AayushmanDas/LucidAC/media/3D_viewer.png

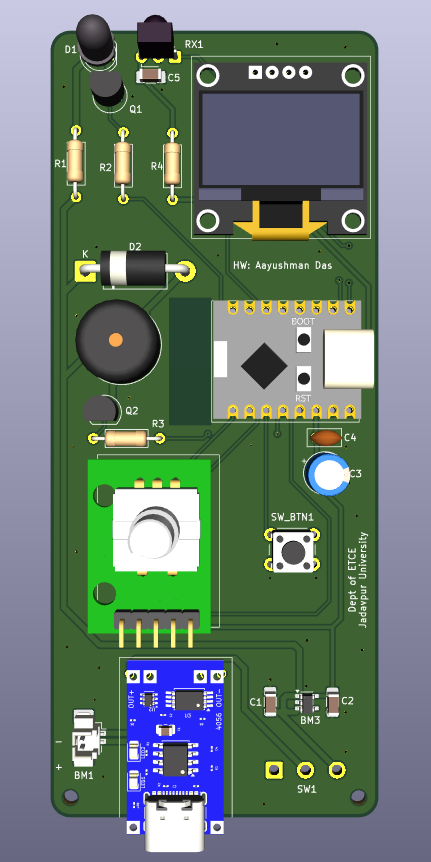
media/3D_viewer.png
