AayushmanDas/LucidAC/media/battery_location.jpg

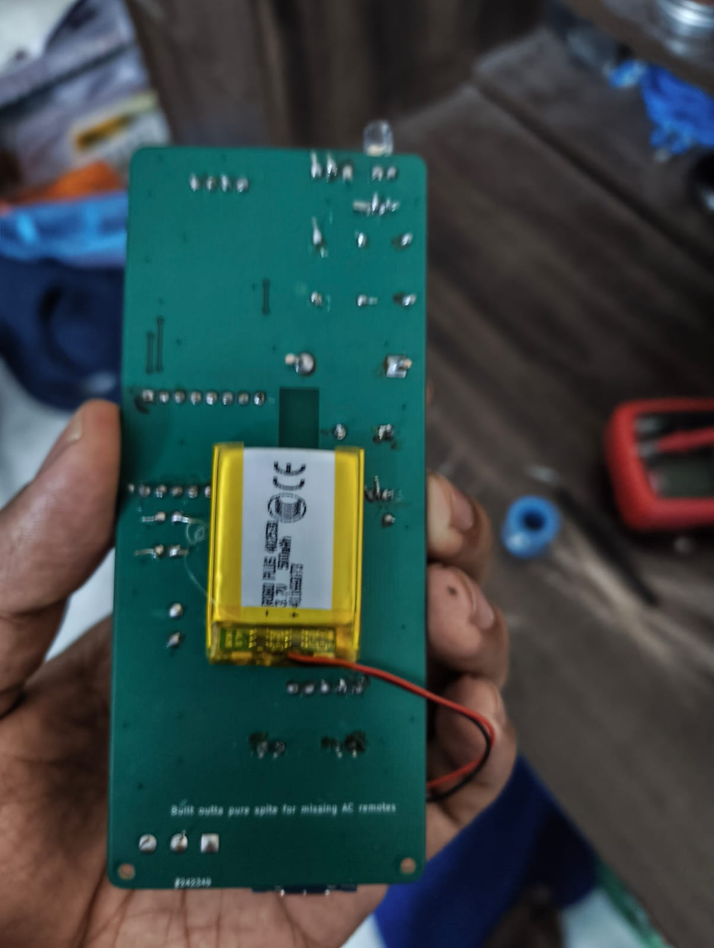
media/battery_location.jpg
