AayushmanDas/LucidAC/media/eschema_view.png

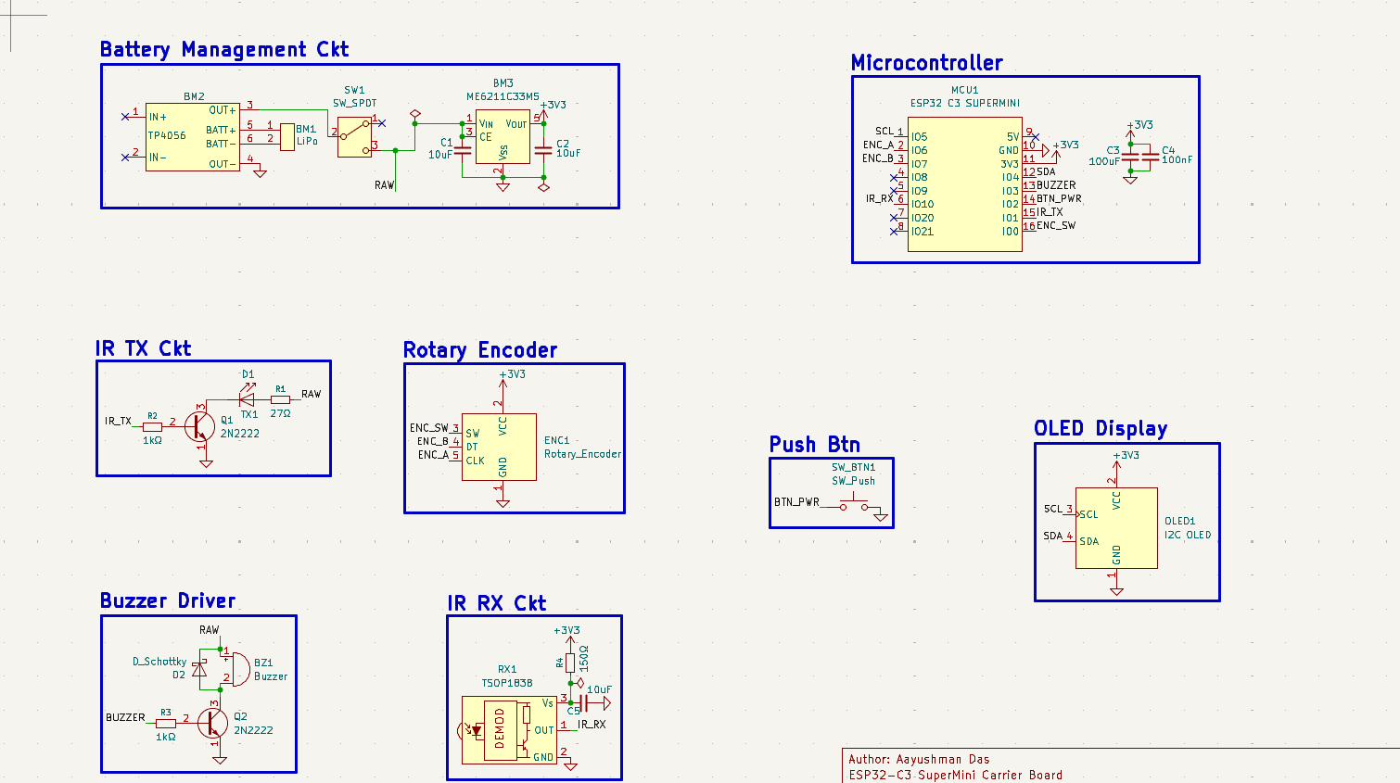
media/eschema_view.png
