AayushmanDas/LucidAC/media/pcbnew_view.png

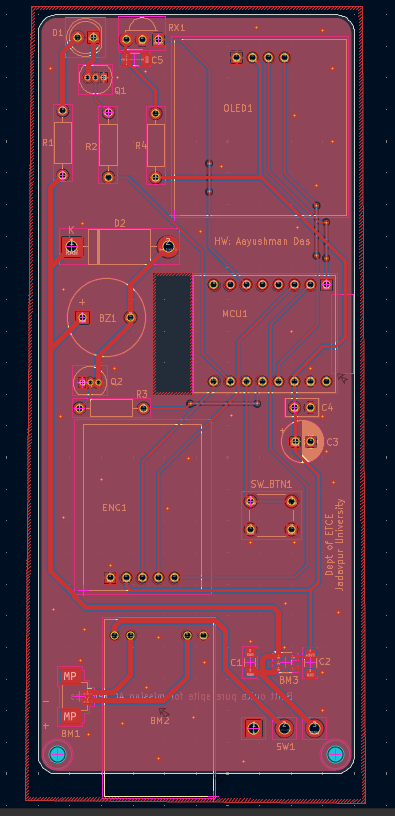
media/pcbnew_view.png
