AayushmanDas/LucidAC/media/ui_demo.jpg

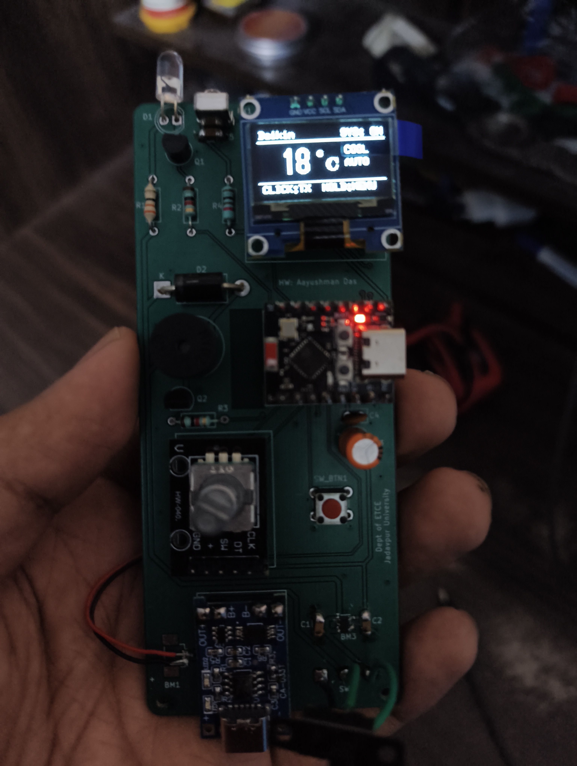
media/ui_demo.jpg
