AayushmanDas/LucidAC/hardware/JU_IR_Clean/Custom_3D_Models/HW-040 Encoder module.stp

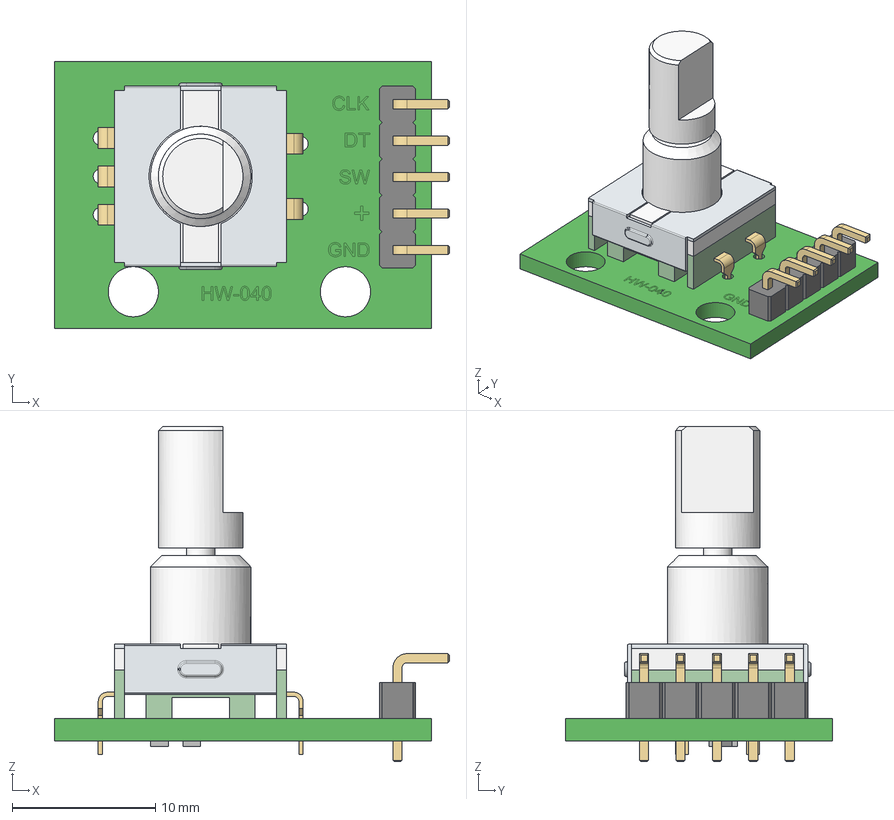
[picture p7: CAD file, 2026-10-14]
hardware/JU_IR_Clean/Custom_3D_Models/HW-040 Encoder module.stp
27.6 x 18.6 x 23.4 mm
Encoder PCB
Knob static part
Knob rotary part
Top plate knob
Plastic bottom knob
Encoder terminal x 5
1X5 Pin Socket
Bend pin x 5
0805 Terminal x 4
0805 Resistor Body x 2
