AayushmanDas/LucidAC/mechanical/JU_IR_Clean.step

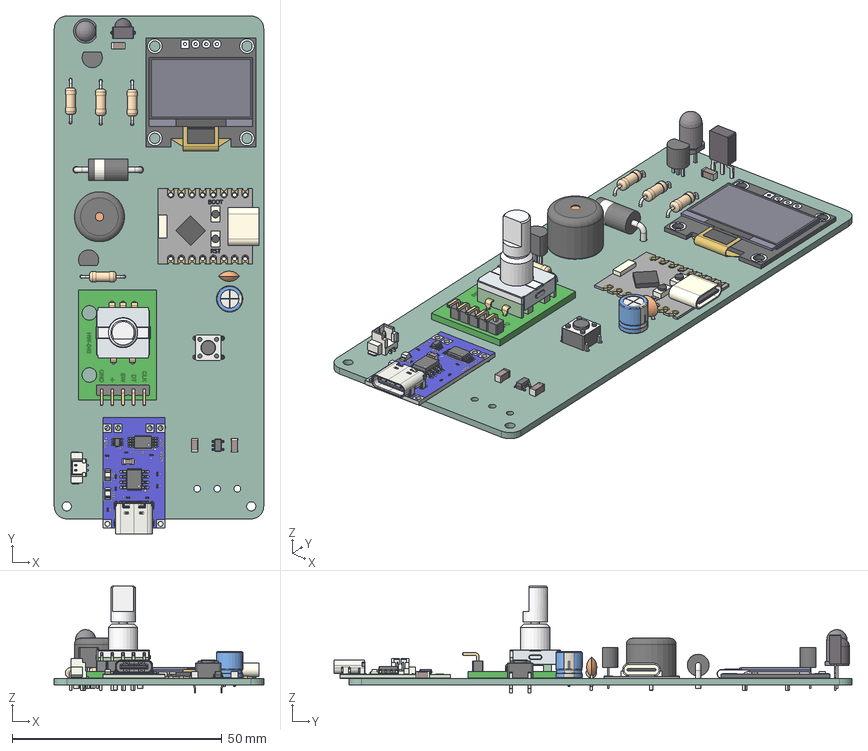
[picture p8: CAD file, 2026-10-14]
mechanical/JU_IR_Clean.step
50.0 x 123.6 x 25.4 mm
SW_PUSH_6mm
Molex_53398_0271
C_1206_3216Metric x 3
CP_Radial_D63mm_P250mm
R_Axial_DIN0207_L63mm_D25mm_P1016mm_Horizontal x 4
Vishay_MINICAST-3pin
Buzzer_12x95RM76
LED_D5.0mm_IRGrey
D_DO-201AD_P15.24mm_Horizontal
C_Disc_D50mm_W25mm_P250mm
TO-92_Inline_Narrow x 2
SOT-23-5
Body - PCB
Body - Back Panel
Body - Adhesive Pad
Body - Front Panel
Body - Flex Connector Bend
Body - Flex Connector Terminals
Body - Black Tape
Body - Protective Foil
Body - Screen Border
Extrude - Annular Rings
Encoder PCB
Knob static part
Knob rotary part
Top plate knob
Plastic bottom knob
Encoder terminal x 5
1X5 Pin Socket
Bend pin x 5
0805 Terminal x 4
0805 Resistor Body x 2
R_01005_0402Metric x 7
C_01005_0402Metric x 3
LED_0805_2012Metric x 2
SOT-363_SC-70-6
SOIC-8_3.9x4.9mm_P1.27mm
TSSOP-8_4.4x3mm_P0.65mm
USB_C_Receptacle_16P_TopMnt_Horizontal_GCT_USB4105-xx-A
C_0805_2012Metric
TP41F36_pad
TP41F36_silkscreen
TP41F36_soldermask x 2
TP41F36_PCB
JU_2A8B_PCB
