AayushmanDas/LucidAC/mechanical/IR_Enclosure.stl

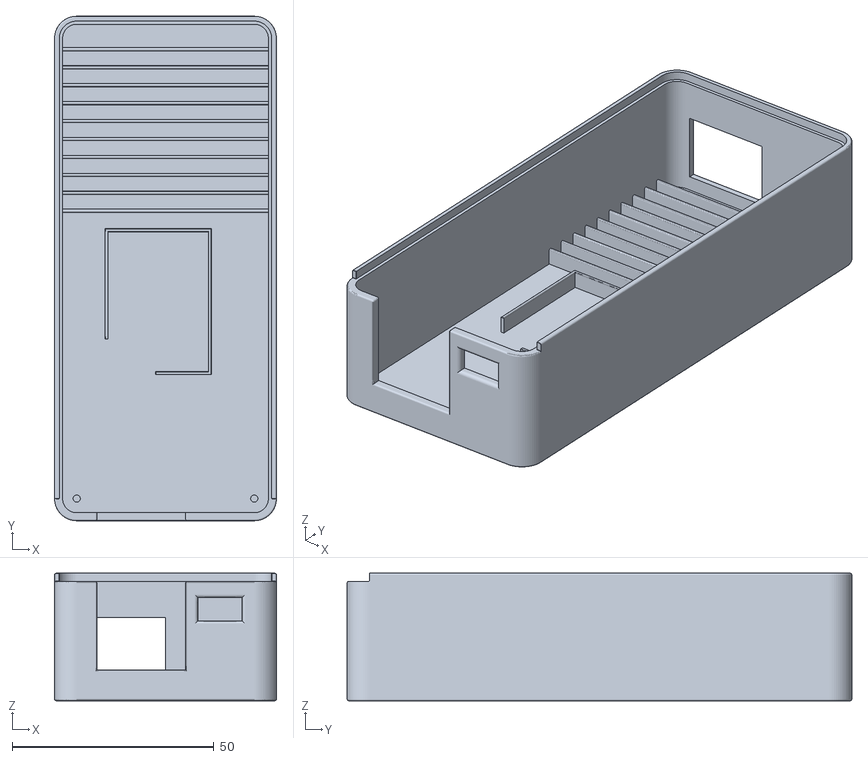
[picture p9: CAD file, 2026-10-14]
mechanical/IR_Enclosure.stl
55.0 x 125.0 x 31.6
