AayushmanDas/LucidAC/hardware/JU_IR_Clean/JU_IR_Clean.kicad_pcb

## KiCad design hardware/JU_IR_Clean/JU_IR_Clean.kicad_pcb (2026-10-14)

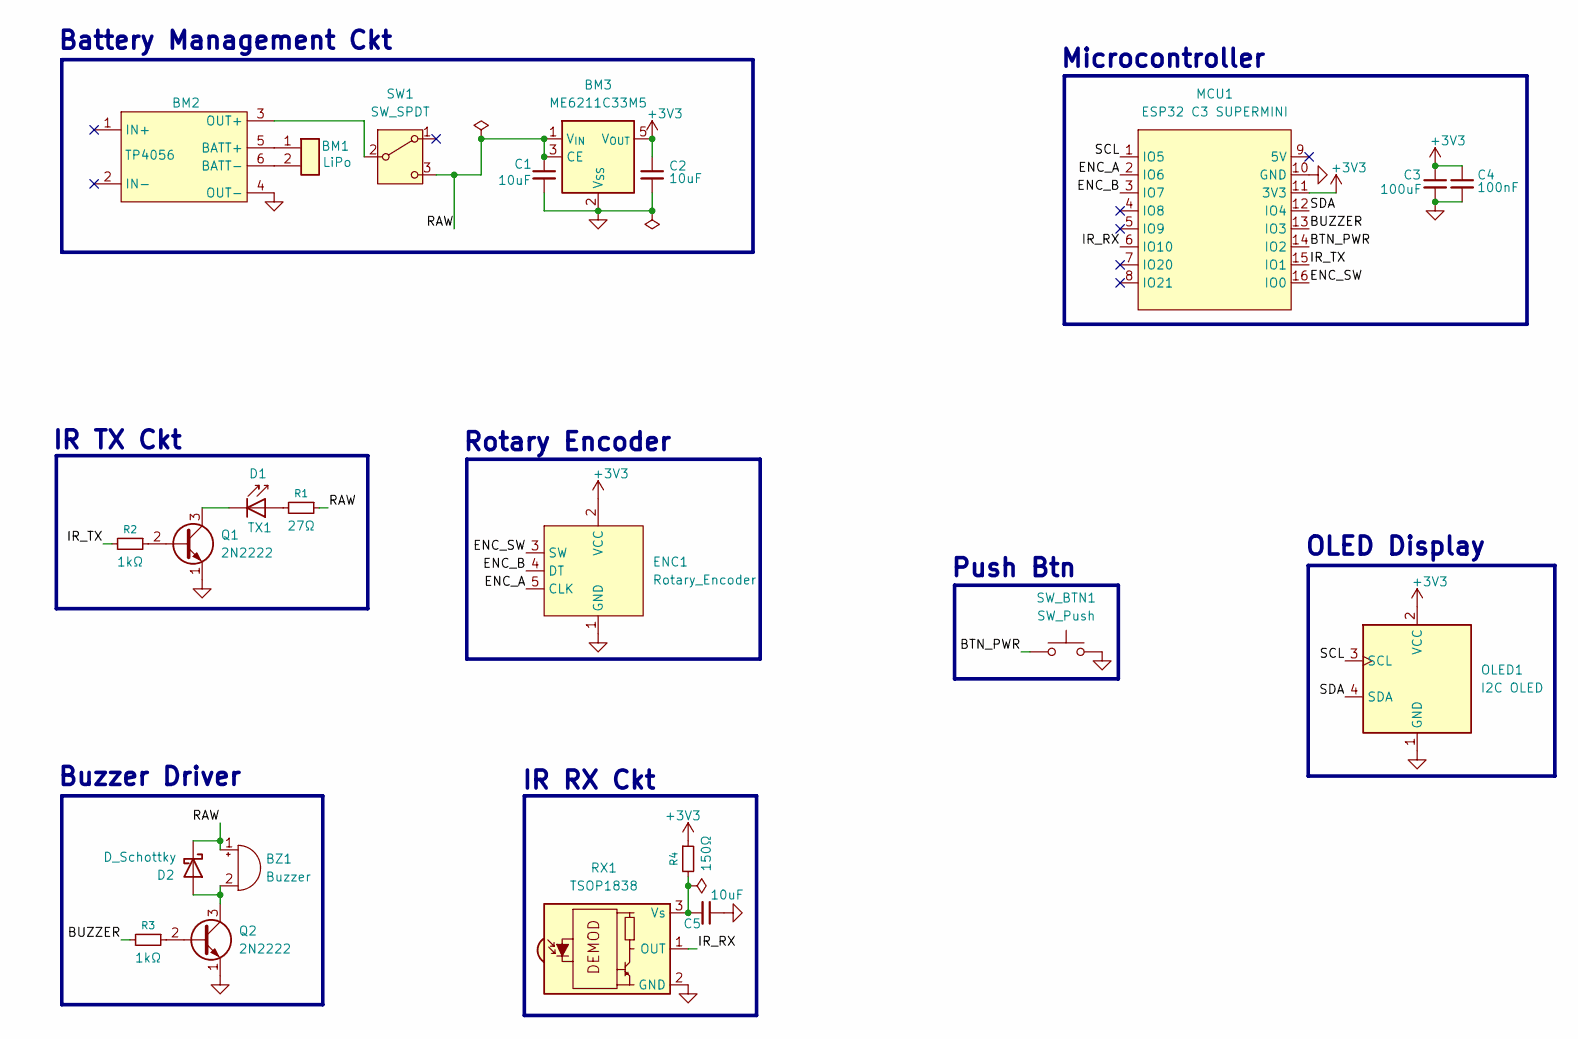
[picture p10: schematic JU_IR_Clean.kicad_sch, Universal AC Transceiver]

Parts:
BM1: LiPo; Molex_PicoBlade_53398-0271_1x02-1MP_P1.25mm_Vertical
BM2: TP4056
BM3: ME6211C33M5; SOT-23-5
BZ1: Buzzer; Buzzer_12x9.5RM7.6
C1, C2, C5: 10uF; C_1206_3216Metric_Pad1.33x1.80mm_HandSolder
C3: 100uF; CP_Radial_D6.3mm_P2.50mm
C4: 100nF; C_Disc_D5.0mm_W2.5mm_P2.50mm
D1: TX1; LED_D5.0mm_IRGrey
D2: D_Schottky; D_DO-201AD_P15.24mm_Horizontal
ENC1: Rotary_Encoder; HW-040_Rotary_Encoder
MCU1: ESP32 C3 SUPERMINI; ESP32_C3_SuperMini
OLED1: I2C OLED; OLED_0.96
Q1, Q2: 2N2222; TO-92_Inline
R1: 27Ω; R_Axial_DIN0207_L6.3mm_D2.5mm_P10.16mm_Horizontal
R2, R3: 1kΩ; R_Axial_DIN0207_L6.3mm_D2.5mm_P10.16mm_Horizontal
R4: 150Ω; R_Axial_DIN0207_L6.3mm_D2.5mm_P10.16mm_Horizontal
RX1: TSOP1838; Vishay_MINICAST-3Pin
SW1: SW_SPDT; SolderWire-0.75sqmm_1x03_P4.8mm_D1.25mm_OD2.3mm
SW_BTN1: SW_Push; SW_PUSH_6mm

Connections:
+3V3: BM3.5 (V_{OUT}), C2.1, C3.1, C4.1, ENC1.2 (VCC), MCU1.11 (3V3), OLED1.2 (VCC), R4.1
/BTN_PWR: MCU1.14 (IO2), SW_BTN1.1
/BUZZER: MCU1.13 (IO3), R3.2
/ENC_A: ENC1.5 (CLK), MCU1.2 (IO6)
/ENC_B: ENC1.4 (DT), MCU1.3 (IO7)
/ENC_SW: ENC1.3 (SW), MCU1.16 (IO0)
/IR_RX: MCU1.6 (IO10), RX1.1 (OUT)
/IR_TX: MCU1.15 (IO1), R2.2
/RAW: BM3.1 (V_{IN}), BM3.3 (CE), BZ1.1 (+), C1.1, D2.1 (K), R1.1, SW1.3 (C)
/SCL: MCU1.1 (IO5), OLED1.3 (SCL)
/SDA: MCU1.12 (IO4), OLED1.4 (SDA)
GND: BM2.4 (OUT-), BM3.2 (V_{SS}), C1.2, C2.2, C3.2, C4.2, C5.1, ENC1.1 (GND), MCU1.10 (GND), OLED1.1 (GND), Q1.1 (E), Q2.1 (E), RX1.2 (GND), SW_BTN1.2
unnamed: BM1.1 (+), BM2.5 (BATT+)
unnamed: BM1.2 (-), BM2.6 (BATT-)
unnamed: BM2.3 (OUT+), SW1.2 (B)
unnamed: BZ1.2 (-), D2.2 (A), Q2.3 (C)
unnamed: D1.2 (A), R1.2
unnamed: D1.1 (K), Q1.3 (C)
unnamed: Q1.2 (B), R2.1
unnamed: Q2.2 (B), R3.1
unnamed: C5.2, R4.2, RX1.3 (Vs)

Notes on the sheet:
Battery Management Ckt
Push Btn
OLED Display
Microcontroller
Buzzer Driver
IR RX Ckt
IR TX Ckt
Rotary Encoder

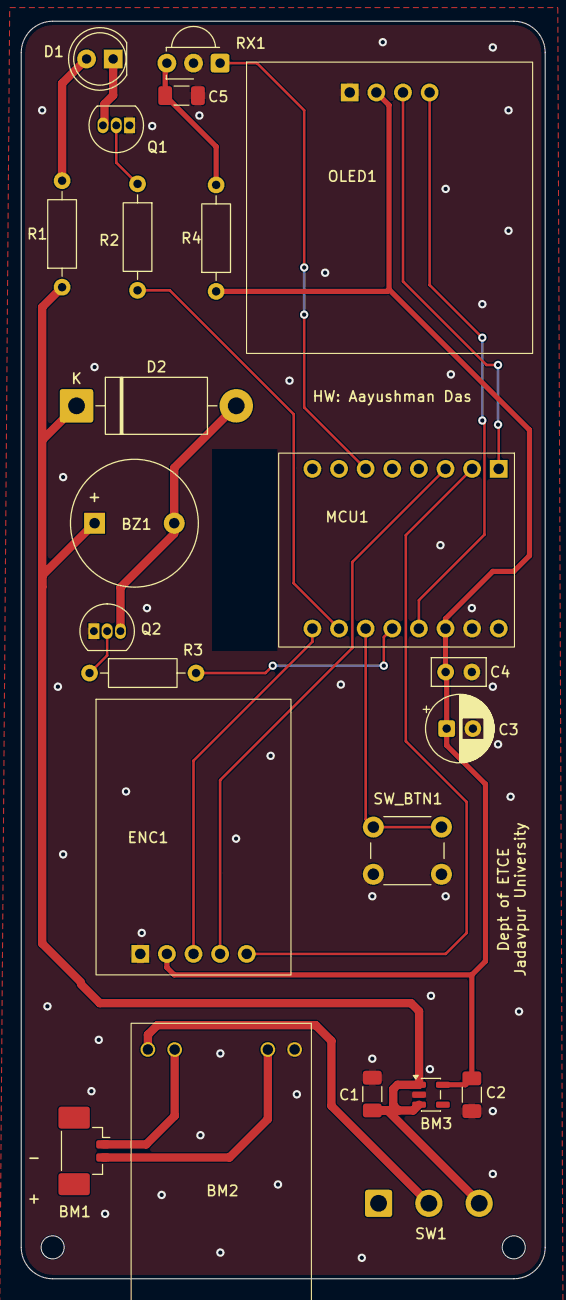
[picture p11: board JU_IR_Clean.kicad_pcb from above]

Board: 2 copper layers, 50.0 x 120.0 mm, 23 parts (0 on the bottom side), 21 nets.
