AayushmanDas/LucidAC/media/internal_assembly.jpg

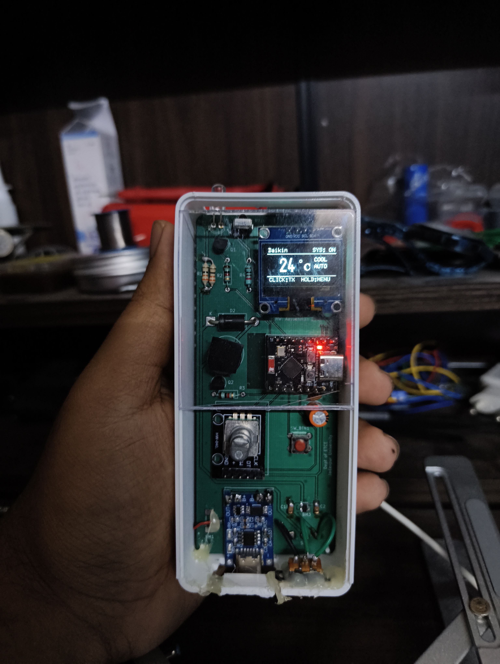
media/internal_assembly.jpg
