AayushmanDas/LucidAC/(commit log)

2026-10-15 Added the image showcasing the battery position
2026-10-15 Added kicad screenshots
